open-plc-com/PLC-modem/plc_pill_electric_scheme.pdf

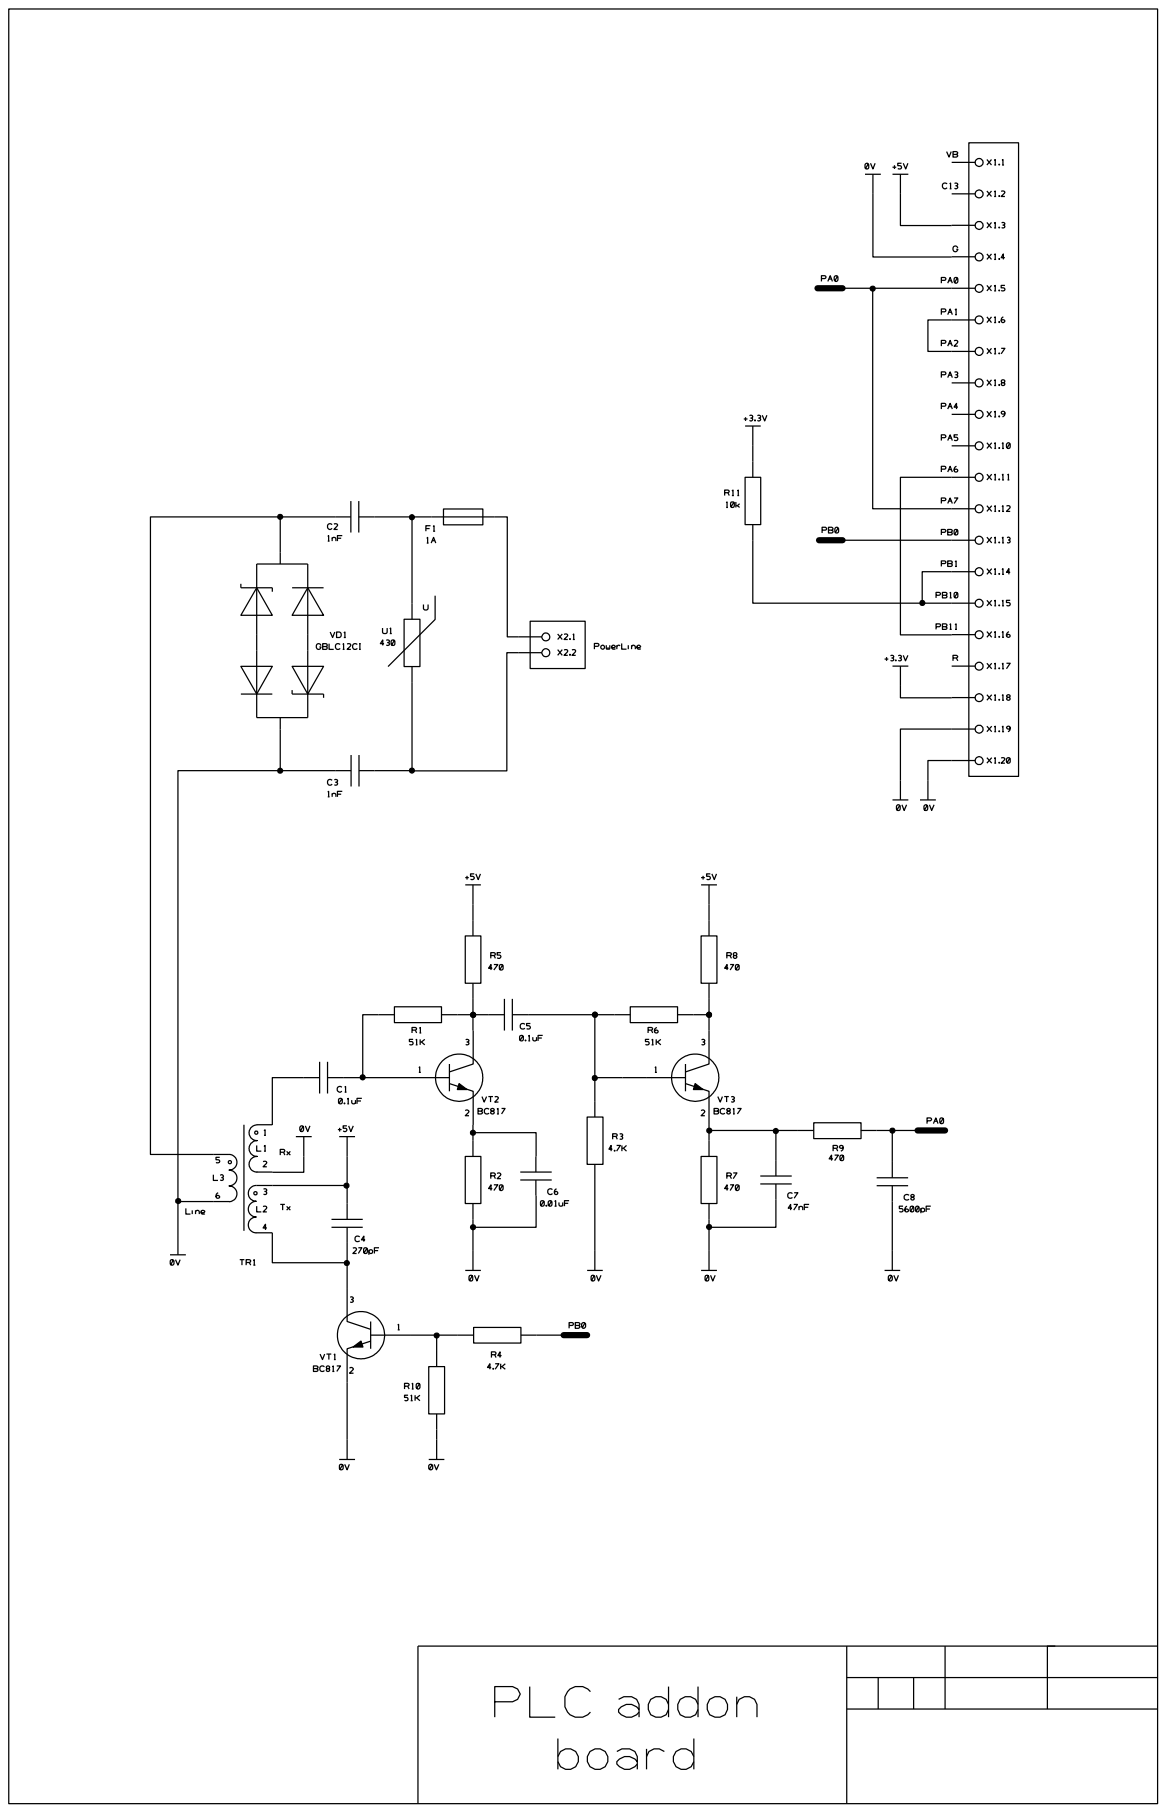
[picture p6: page 1]
