open-plc-com/PLC-modem/(list of files, drawings)

Other design files:
plc_pill_electric_scheme.pcb
