open-plc-com/PLC-modem/(commit log)

2020-08-14 new file: plc_pill_electric_scheme.pcb
    [plc_pill_electric_scheme.pcb]
2020-08-14 deleted: plc_pill_electric_scheme.pcb
    [plc_pill_electric_scheme.pcb]
